algofoogle/ttihp0p3-antonalog/xschem/r2r_dac.pdf

## r2r_dac.sch

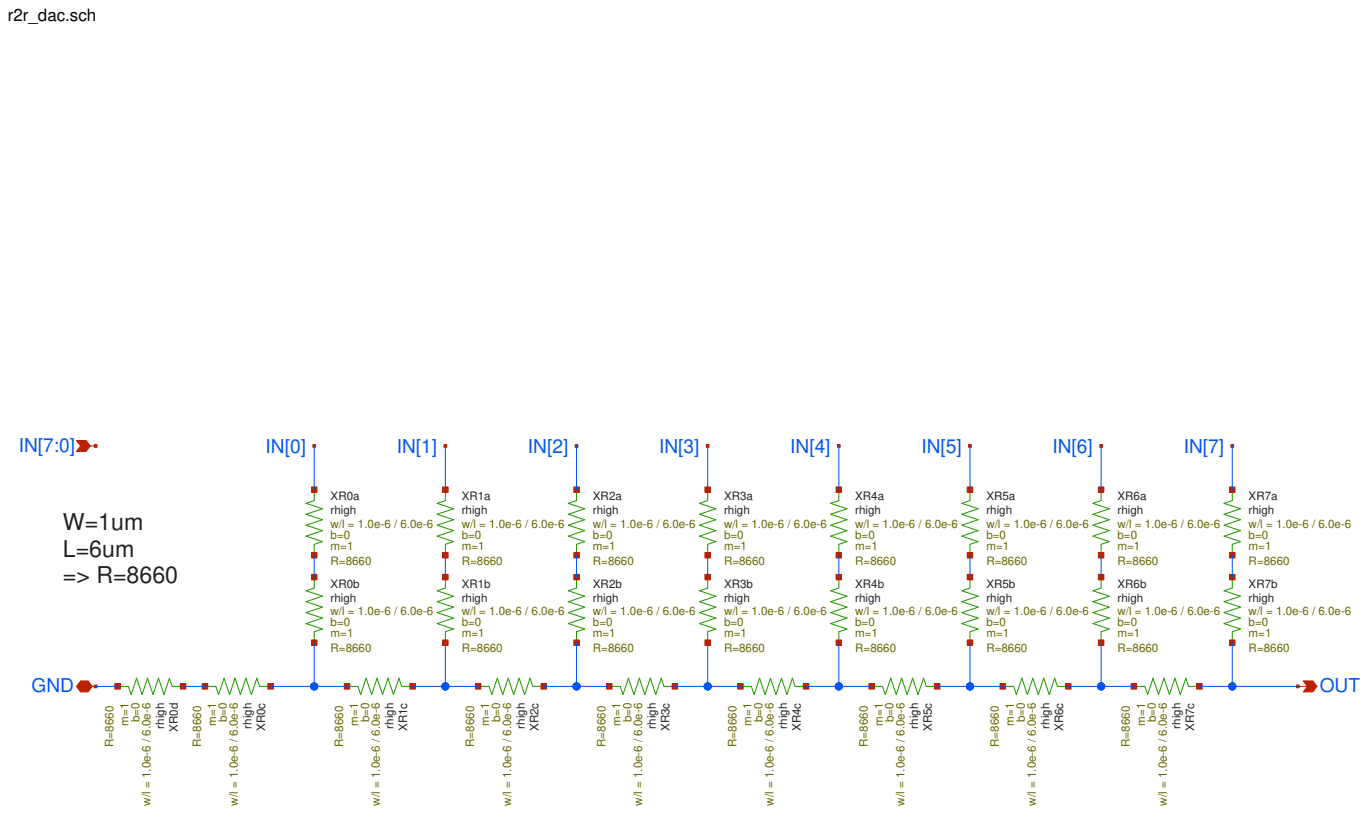
[picture p1: page 1]
rhigh; GND; OUT
