algofoogle/ttihp0p3-antonalog/verilog/gl/controller.pnl.v

module controller (b6,
    b7,
    clk,
    ena,
    g6,
    g7,
    hblank,
    hsync,
    r6,
    r7,
    rst_n,
    uio_out2,
    uio_out3,
    uio_out4,
    uio_out5,
    uio_out6,
    uio_out7,
    vblank,
    vsync,
    VPWR,
    VGND,
    db,
    dg,
    dr,
    ui_in,
    uio_oe);
 output b6;
 output b7;
 input clk;
 input ena;
 output g6;
 output g7;
 output hblank;
 output hsync;
 output r6;
 output r7;
 input rst_n;
 output uio_out2;
 output uio_out3;
 output uio_out4;
 output uio_out5;
 output uio_out6;
 output uio_out7;
 output vblank;
 output vsync;
 inout VPWR;
 inout VGND;
 output [7:0] db;
 output [7:0] dg;
 output [7:0] dr;
 input [7:0] ui_in;
 output [1:0] uio_oe;

 wire _0000_;
 wire _0001_;
 wire _0002_;
 wire _0003_;
 wire _0004_;
 wire _0005_;
 wire _0006_;
 wire _0007_;
 wire _0008_;
 wire _0009_;
 wire _0010_;
 wire _0011_;
 wire _0012_;
 wire _0013_;
 wire _0014_;
 wire _0015_;
 wire _0016_;
 wire _0017_;
 wire _0018_;
 wire _0019_;
 wire _0020_;
 wire _0021_;
 wire _0022_;
 wire _0023_;
 wire _0024_;
 wire _0025_;
 wire _0026_;
 wire _0027_;
 wire _0028_;
 wire _0029_;
 wire _0030_;
 wire _0031_;
 wire _0032_;
 wire _0033_;
 wire _0034_;
 wire _0035_;
 wire _0036_;
 wire _0037_;
 wire _0038_;
 wire _0039_;
 wire _0040_;
 wire _0041_;
 wire _0042_;
 wire _0043_;
 wire _0044_;
 wire _0045_;
 wire _0046_;
 wire _0047_;
 wire _0048_;
 wire _0049_;
 wire _0050_;
 wire _0051_;
 wire _0052_;
 wire _0053_;
 wire _0054_;
 wire _0055_;
 wire _0056_;
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
    .B1(_0147_),
    .B2(_0149_),
    .A2(_0144_),
    .A1(_0143_),
    .VDD(VPWR),
    .VSS(VGND));
 sg13g2_nor2_1 _1955_ (.A(net78),
    .B(_0150_),
    .Y(_0151_),
    .VDD(VPWR),
    .VSS(VGND));
 sg13g2_nand2b_1 _1956_ (.Y(_0152_),
    .B(_0147_),
    .A_N(_0139_),
    .VDD(VPWR),
    .VSS(VGND));
 sg13g2_a21oi_1 _1957_ (.VSS(VGND),
    .VDD(VPWR),
    .A1(_0150_),
    .A2(_0152_),
    .Y(_0069_),
    .B1(_0151_));
 sg13g2_nor2_2 _1958_ (.A(_0933_),
    .B(_0961_),
    .Y(_0153_),
    .VDD(VPWR),
    .VSS(VGND));
 sg13g2_o21ai_1 _1959_ (.B1(net424),
    .VDD(VPWR),
    .Y(_0154_),
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
