algofoogle/ttihp0p3-antonalog/verilog/gl/rgb_buffers.pnl.v

module rgb_buffers (VPWR,
    VGND,
    b,
    db,
    dg,
    dr,
    g,
    r);
 inout VPWR;
 inout VGND;
 output [7:0] b;
 input [7:0] db;
 input [7:0] dg;
 input [7:0] dr;
 output [7:0] g;
 output [7:0] r;


 sg13g2_buf_8 \rgb_buffer_cell[0]  (.A(db[0]),
    .X(b[0]),
    .VDD(VPWR),
    .VSS(VGND));
 sg13g2_buf_8 \rgb_buffer_cell[10]  (.A(dg[2]),
    .X(g[2]),
    .VDD(VPWR),
    .VSS(VGND));
 sg13g2_buf_8 \rgb_buffer_cell[11]  (.A(dg[3]),
    .X(g[3]),
    .VDD(VPWR),
    .VSS(VGND));
 sg13g2_buf_8 \rgb_buffer_cell[12]  (.A(dg[4]),
    .X(g[4]),
    .VDD(VPWR),
    .VSS(VGND));
 sg13g2_buf_8 \rgb_buffer_cell[13]  (.A(dg[5]),
    .X(g[5]),
    .VDD(VPWR),
    .VSS(VGND));
 sg13g2_buf_8 \rgb_buffer_cell[14]  (.A(dg[6]),
    .X(g[6]),
    .VDD(VPWR),
    .VSS(VGND));
 sg13g2_buf_8 \rgb_buffer_cell[15]  (.A(dg[7]),
    .X(g[7]),
    .VDD(VPWR),
    .VSS(VGND));
 sg13g2_buf_8 \rgb_buffer_cell[16]  (.A(dr[0]),
    .X(r[0]),
    .VDD(VPWR),
    .VSS(VGND));
 sg13g2_buf_8 \rgb_buffer_cell[17]  (.A(dr[1]),
    .X(r[1]),
    .VDD(VPWR),
    .VSS(VGND));
 sg13g2_buf_8 \rgb_buffer_cell[18]  (.A(dr[2]),
    .X(r[2]),
    .VDD(VPWR),
    .VSS(VGND));
 sg13g2_buf_8 \rgb_buffer_cell[19]  (.A(dr[3]),
    .X(r[3]),
    .VDD(VPWR),
    .VSS(VGND));
 sg13g2_buf_8 \rgb_buffer_cell[1]  (.A(db[1]),
    .X(b[1]),
    .VDD(VPWR),
    .VSS(VGND));
 sg13g2_buf_8 \rgb_buffer_cell[20]  (.A(dr[4]),
    .X(r[4]),
    .VDD(VPWR),
    .VSS(VGND));
 sg13g2_buf_8 \rgb_buffer_cell[21]  (.A(dr[5]),
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
    .VSS(VGND));
 sg13g2_decap_8 FILLER_32_14 (.VDD(VPWR),
    .VSS(VGND));
 sg13g2_decap_8 FILLER_33_0 (.VDD(VPWR),
    .VSS(VGND));
 sg13g2_decap_8 FILLER_33_7 (.VDD(VPWR),
    .VSS(VGND));
 sg13g2_decap_8 FILLER_33_14 (.VDD(VPWR),
    .VSS(VGND));
endmodule
