algofoogle/ttihp0p3-antonalog/(commit log)

2025-05-09 Adding in main design with completed magic layout
    [pin_order.cfg, r2r_dac.sch, tb_r2r_dac.sch]
2025-05-10 Create rgb_buffers macro. Still need to place it
    [pin_order.cfg]
2025-05-10 Reworked layout: rgb_buffers macro, tidy-up, north-side power connected too
2025-05-17 Layout R2. r2r_dac: push rhighs closer to merge nSD. Redo rgb_buffer, top layout accordingly
    [pin_order.cfg, r2r_dac.sch]
